antonioastorino/Arduino-Micro-Keyboard/kicad/keyboard.kicad_pcb

## KiCad design kicad/keyboard.kicad_pcb (2024-11-29)

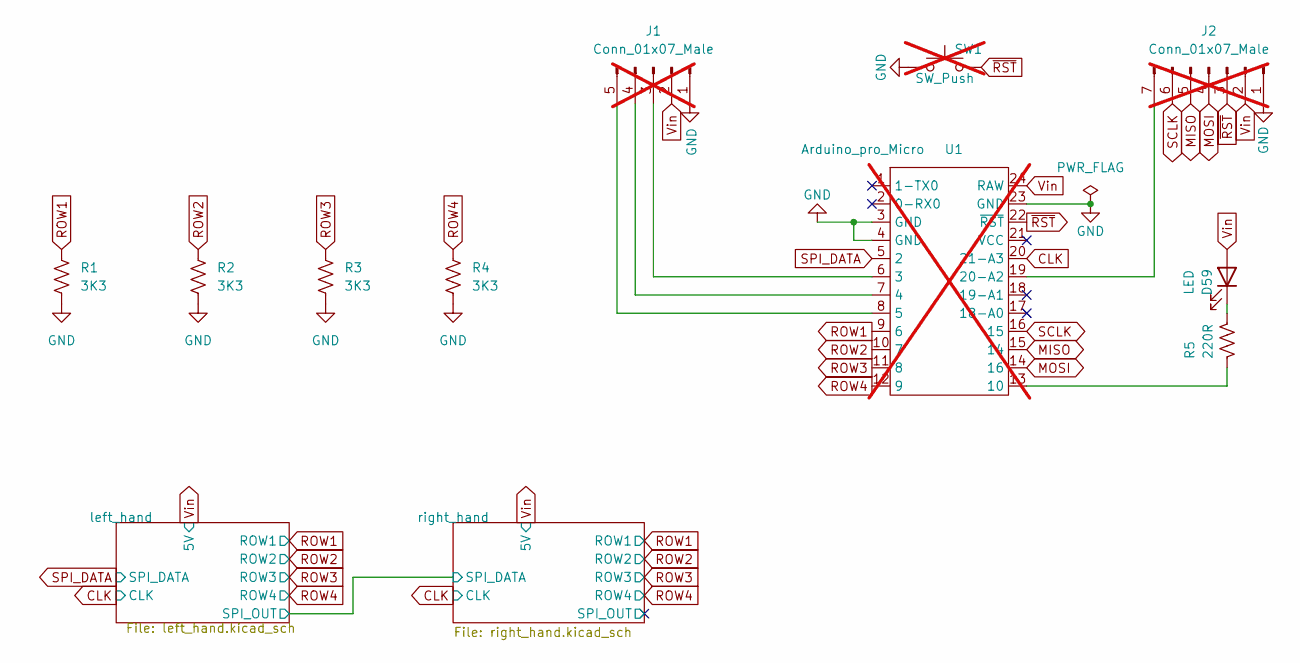
[picture p1: schematic keyboard.kicad_sch]

Parts:
D59: LED; LED_0805_2012Metric; LCSC C2296
J1: Conn_01x07_Male; PinHeader_1x05_P2.54mm_Vertical; not fitted
J2: Conn_01x07_Male; PinHeader_01x07; not fitted
R1, R2, R3, R4: 3K3; R_0603_1608Metric; LCSC C22978
R5: 220R; R_0603_1608Metric; LCSC C22962
SW1: SW_Push; DIP-2_P5.08mm; not fitted
U1: Arduino_pro_Micro; DIP-24_W15.24mm; not fitted

Connections:
CLK: U1.20 (21-A3); also elsewhere on the board
GND: J1.1, J2.1, R1.2, R2.2, R3.2, R4.2, SW1.1, U1.3 (GND), U1.4 (GND), U1.23 (GND); also elsewhere on the board
MISO: J2.5, U1.15 (14)
MOSI: J2.4, U1.14 (16)
unnamed: D59.1 (K), R5.2
unnamed: J1.3, U1.6 (3)
unnamed: J1.4, U1.7 (4)
unnamed: J1.5, U1.8 (5)
unnamed: J2.7, U1.19 (20-A2)
unnamed: R5.1, U1.13 (10)
ROW1: R1.1, U1.9 (6); also elsewhere on the board
ROW2: R2.1, U1.10 (7); also elsewhere on the board
ROW3: R3.1, U1.11 (8); also elsewhere on the board
ROW4: R4.1, U1.12 (9); also elsewhere on the board
SCLK: J2.6, U1.16 (15)
SPI_DATA: U1.5 (2); also elsewhere on the board
Vin: D59.2 (A), J1.2, J2.2, U1.24 (RAW); also elsewhere on the board
~RST: J2.3, SW1.2, U1.22 (~RST)

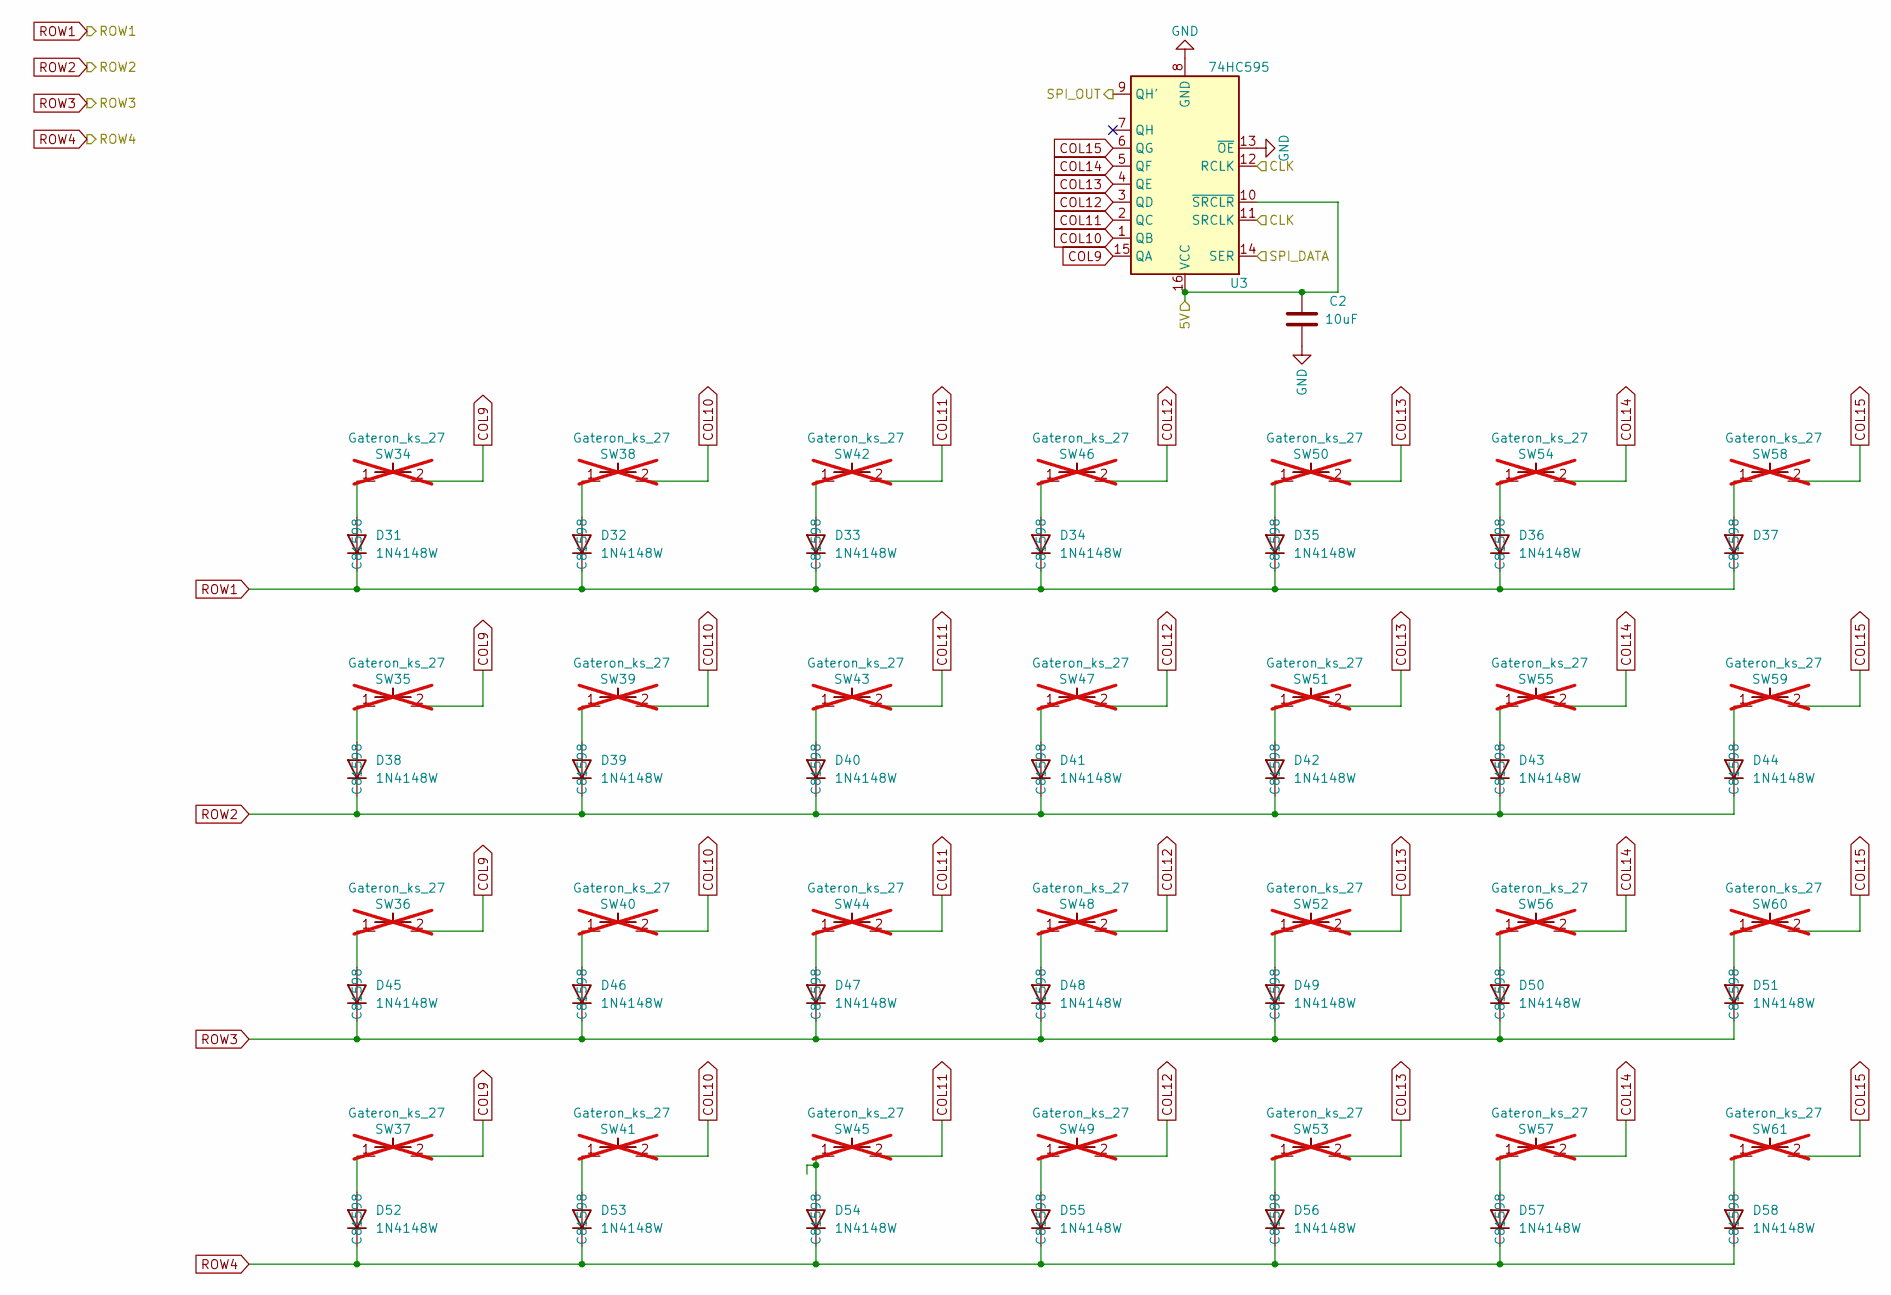
[picture p2: schematic right_hand.kicad_sch]

Parts:
C2: 10uF; C_0603_1608Metric; LCSC C19702
D31, D32, D33, D34, D35, D36, D37, D38, D39, D40, D41, D42, D43, D44, D45, D46, D47, D48, D49, D50, D51, D52, D53, D54, D55, D56, D57, D58: 1N4148W; D_SOD-123; LCSC C81598
SW34, SW35, SW36, SW37, SW38, SW39, SW40, SW41, SW42, SW43, SW44, SW45, SW46, SW47, SW48, SW49, SW50, SW51, SW52, SW53, SW54, SW55, SW56, SW57, SW58, SW59, SW60, SW61: Gateron_ks_27; not fitted
U3: 74HC595; SO-16_3.9x9.9mm_P1.27mm; LCSC C5947

Connections:
/left_hand/SPI_OUT: U3.14 (SER); also elsewhere on the board
/right_hand/SPI_OUT: U3.9 (QH')
CLK: U3.11 (SRCLK), U3.12 (RCLK); also elsewhere on the board
COL9: SW34.2, SW35.2, SW36.2, SW37.2, U3.15 (QA)
COL10: SW38.2, SW39.2, SW40.2, SW41.2, U3.1 (QB)
COL11: SW42.2, SW43.2, SW44.2, SW45.2, U3.2 (QC)
COL12: SW46.2, SW47.2, SW48.2, SW49.2, U3.3 (QD)
COL13: SW50.2, SW51.2, SW52.2, SW53.2, U3.4 (QE)
COL14: SW54.2, SW55.2, SW56.2, SW57.2, U3.5 (QF)
COL15: SW58.2, SW59.2, SW60.2, SW61.2, U3.6 (QG)
GND: C2.2, U3.8 (GND), U3.13 (~OE); also elsewhere on the board
unnamed: D31.2 (A), SW34.1
unnamed: D32.2 (A), SW38.1
unnamed: D33.2 (A), SW42.1
unnamed: D34.2 (A), SW46.1
unnamed: D35.2 (A), SW50.1
unnamed: D36.2 (A), SW54.1
unnamed: D37.2 (A), SW58.1
unnamed: D38.2 (A), SW35.1
unnamed: D39.2 (A), SW39.1
unnamed: D40.2 (A), SW43.1
unnamed: D41.2 (A), SW47.1
unnamed: D42.2 (A), SW51.1
unnamed: D43.2 (A), SW55.1
unnamed: D44.2 (A), SW59.1
unnamed: D45.2 (A), SW36.1
unnamed: D46.2 (A), SW40.1
unnamed: D47.2 (A), SW44.1
unnamed: D48.2 (A), SW48.1
unnamed: D49.2 (A), SW52.1
unnamed: D50.2 (A), SW56.1
unnamed: D51.2 (A), SW60.1
unnamed: D52.2 (A), SW37.1
unnamed: D53.2 (A), SW41.1
unnamed: D54.2 (A), SW45.1
unnamed: D55.2 (A), SW49.1
unnamed: D56.2 (A), SW53.1
unnamed: D57.2 (A), SW57.1
unnamed: D58.2 (A), SW61.1
ROW1: D31.1 (K), D32.1 (K), D33.1 (K), D34.1 (K), D35.1 (K), D36.1 (K), D37.1 (K); also elsewhere on the board
ROW2: D38.1 (K), D39.1 (K), D40.1 (K), D41.1 (K), D42.1 (K), D43.1 (K), D44.1 (K); also elsewhere on the board
ROW3: D45.1 (K), D46.1 (K), D47.1 (K), D48.1 (K), D49.1 (K), D50.1 (K), D51.1 (K); also elsewhere on the board
ROW4: D52.1 (K), D53.1 (K), D54.1 (K), D55.1 (K), D56.1 (K), D57.1 (K), D58.1 (K); also elsewhere on the board
Vin: C2.1, U3.10 (~SRCLR), U3.16 (VCC); also elsewhere on the board

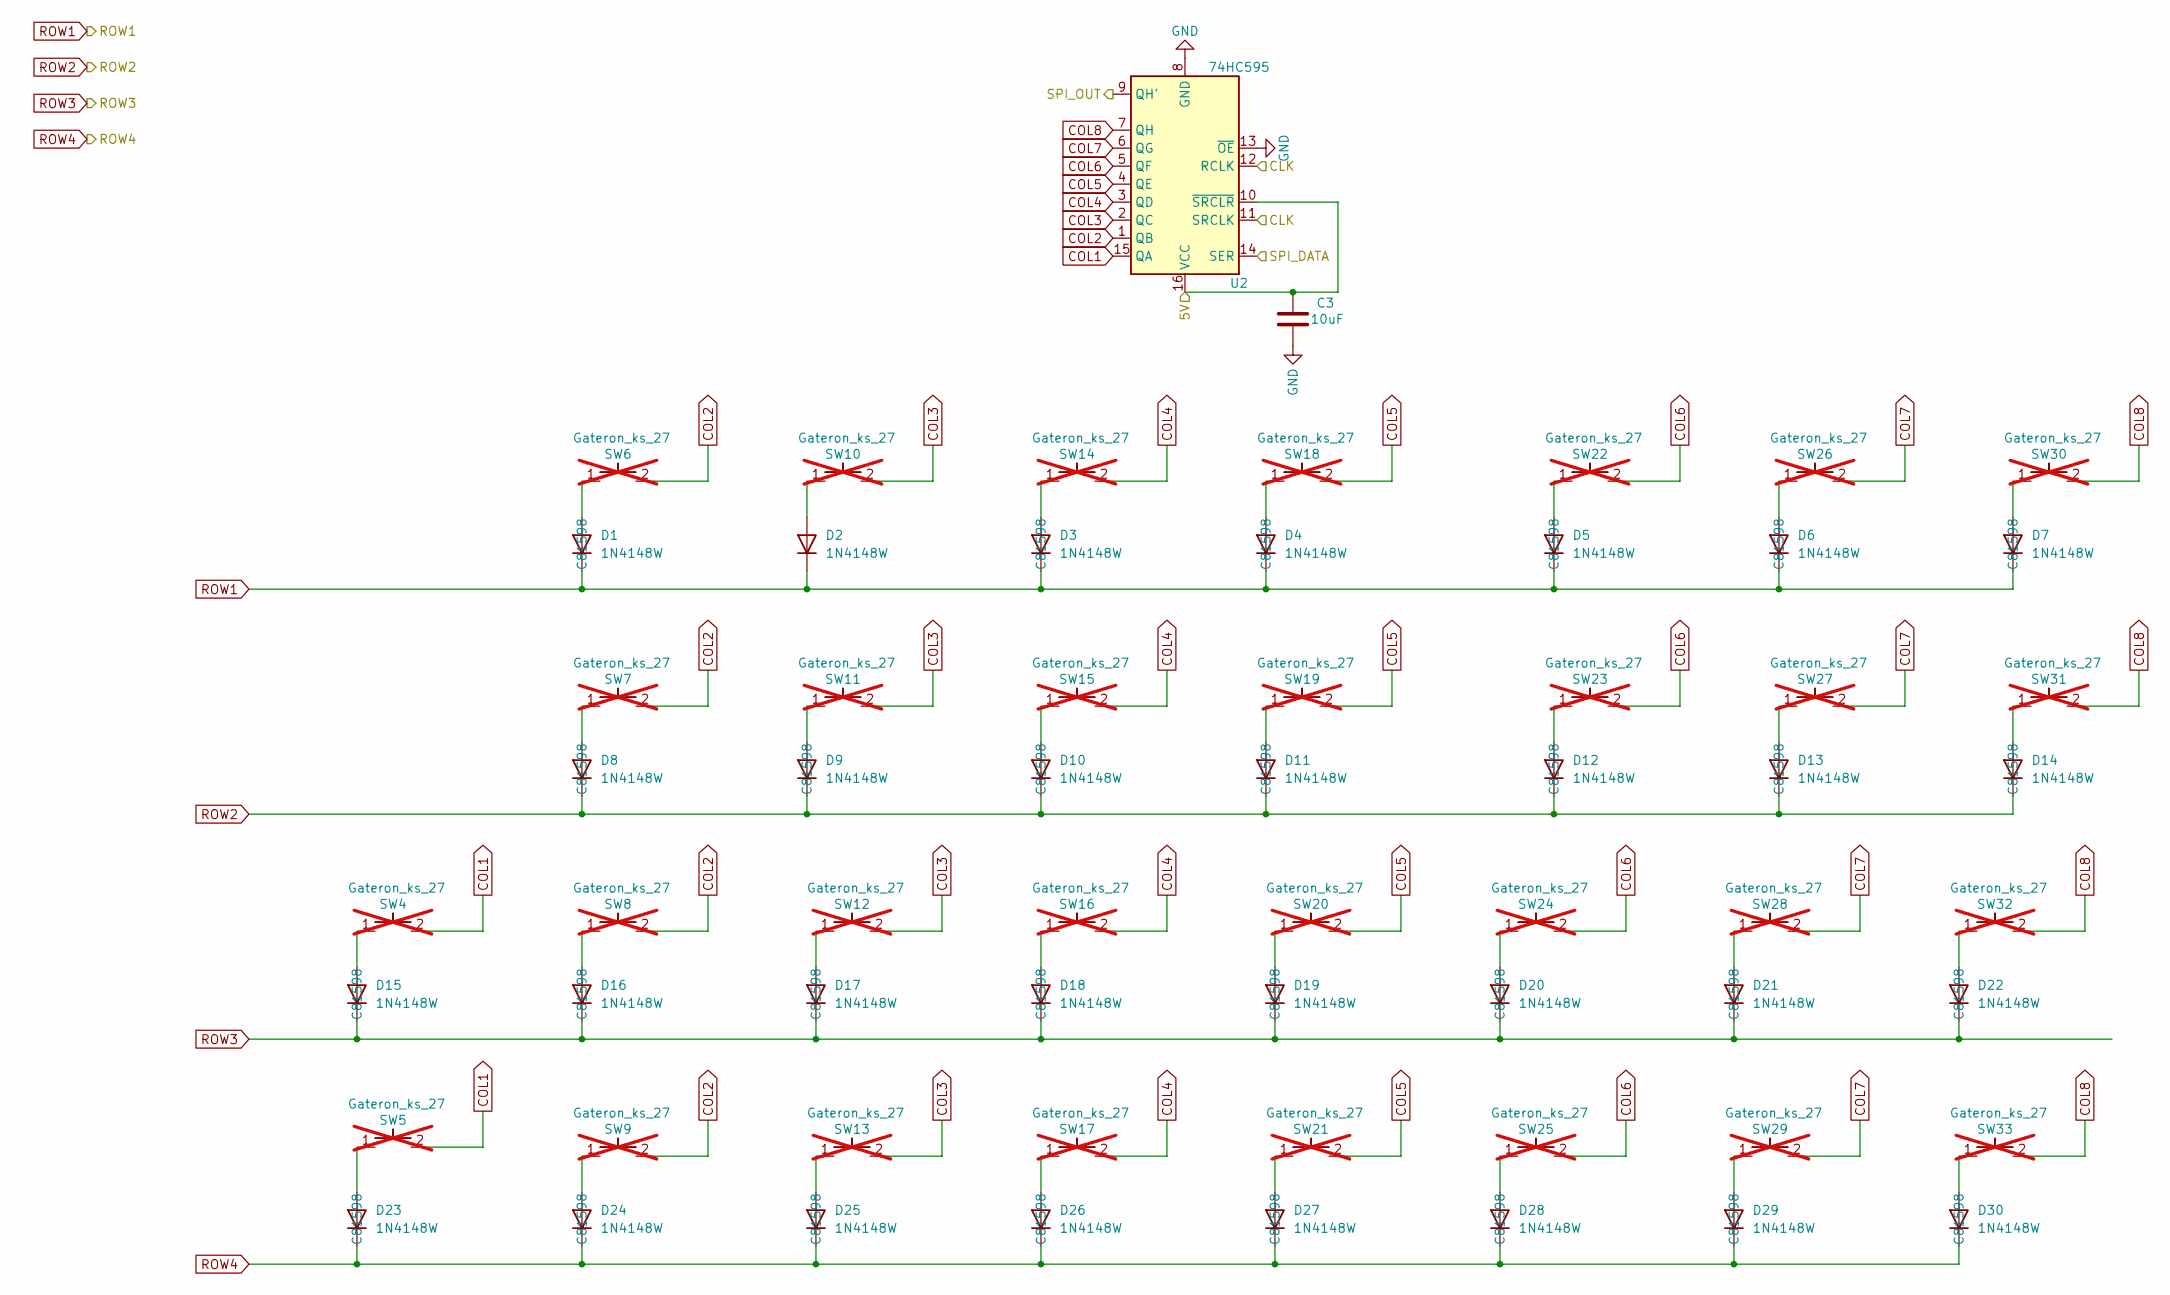
[picture p3: schematic left_hand.kicad_sch]

Parts:
C3: 10uF; C_0603_1608Metric; LCSC C19702
D1, D2, D3, D4, D5, D6, D7, D8, D9, D10, D11, D12, D13, D14, D15, D16, D17, D18, D19, D20, D21, D22, D23, D24, D25, D26, D27, D28, D29, D30: 1N4148W; D_SOD-123; LCSC C81598
SW4, SW5, SW6, SW7, SW8, SW9, SW10, SW11, SW12, SW13, SW14, SW15, SW16, SW17, SW18, SW19, SW20, SW21, SW22, SW23, SW24, SW25, SW26, SW27, SW28, SW29, SW30, SW31, SW32, SW33: Gateron_ks_27; not fitted
U2: 74HC595; SO-16_3.9x9.9mm_P1.27mm; LCSC C5947

Connections:
/left_hand/SPI_OUT: U2.9 (QH'); also elsewhere on the board
CLK: U2.11 (SRCLK), U2.12 (RCLK); also elsewhere on the board
COL1: SW4.2, SW5.2, U2.15 (QA)
COL2: SW6.2, SW7.2, SW8.2, SW9.2, U2.1 (QB)
COL3: SW10.2, SW11.2, SW12.2, SW13.2, U2.2 (QC)
COL4: SW14.2, SW15.2, SW16.2, SW17.2, U2.3 (QD)
COL5: SW18.2, SW19.2, SW20.2, SW21.2, U2.4 (QE)
COL6: SW22.2, SW23.2, SW24.2, SW25.2, U2.5 (QF)
COL7: SW26.2, SW27.2, SW28.2, SW29.2, U2.6 (QG)
COL8: SW30.2, SW31.2, SW32.2, SW33.2, U2.7 (QH)
GND: C3.2, U2.8 (GND), U2.13 (~OE); also elsewhere on the board
unnamed: D1.2 (A), SW6.1
unnamed: D2.2 (A), SW10.1
unnamed: D3.2 (A), SW14.1
unnamed: D4.2 (A), SW18.1
unnamed: D5.2 (A), SW22.1
unnamed: D6.2 (A), SW26.1
unnamed: D7.2 (A), SW30.1
unnamed: D8.2 (A), SW7.1
unnamed: D9.2 (A), SW11.1
unnamed: D10.2 (A), SW15.1
unnamed: D11.2 (A), SW19.1
unnamed: D12.2 (A), SW23.1
unnamed: D13.2 (A), SW27.1
unnamed: D14.2 (A), SW31.1
unnamed: D15.2 (A), SW4.1
unnamed: D16.2 (A), SW8.1
unnamed: D17.2 (A), SW12.1
unnamed: D18.2 (A), SW16.1
unnamed: D19.2 (A), SW20.1
unnamed: D20.2 (A), SW24.1
unnamed: D21.2 (A), SW28.1
unnamed: D22.2 (A), SW32.1
unnamed: D23.2 (A), SW5.1
unnamed: D24.2 (A), SW9.1
unnamed: D25.2 (A), SW13.1
unnamed: D26.2 (A), SW17.1
unnamed: D27.2 (A), SW21.1
unnamed: D28.2 (A), SW25.1
unnamed: D29.2 (A), SW29.1
unnamed: D30.2 (A), SW33.1
ROW1: D1.1 (K), D2.1 (K), D3.1 (K), D4.1 (K), D5.1 (K), D6.1 (K), D7.1 (K); also elsewhere on the board
ROW2: D8.1 (K), D9.1 (K), D10.1 (K), D11.1 (K), D12.1 (K), D13.1 (K), D14.1 (K); also elsewhere on the board
ROW3: D15.1 (K), D16.1 (K), D17.1 (K), D18.1 (K), D19.1 (K), D20.1 (K), D21.1 (K), D22.1 (K); also elsewhere on the board
ROW4: D23.1 (K), D24.1 (K), D25.1 (K), D26.1 (K), D27.1 (K), D28.1 (K), D29.1 (K), D30.1 (K); also elsewhere on the board
SPI_DATA: U2.14 (SER); also elsewhere on the board
Vin: C3.1, U2.10 (~SRCLR), U2.16 (VCC); also elsewhere on the board

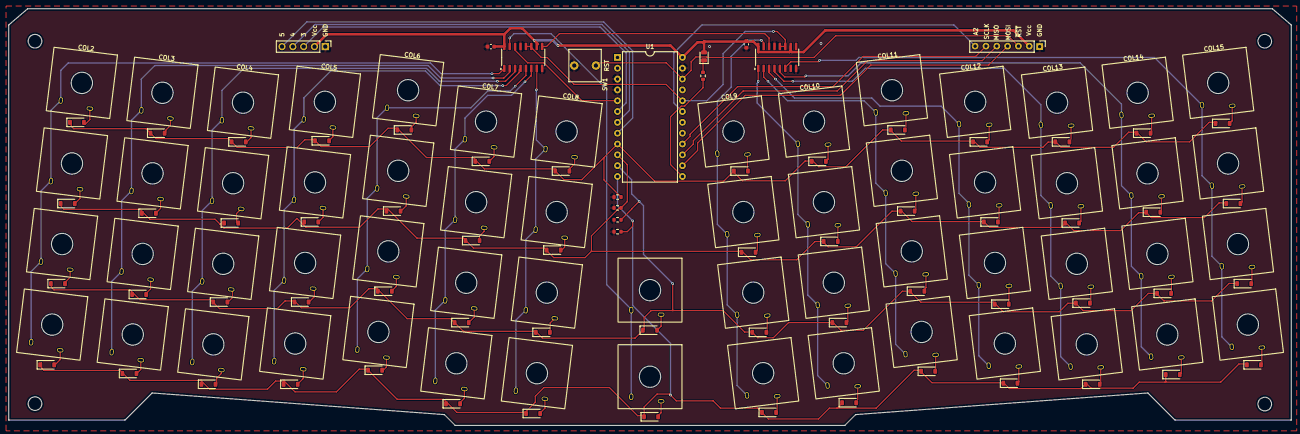
[picture p4: board keyboard.kicad_pcb from above]

Board: 2 copper layers, 301.0 x 97.8 mm, 130 parts (0 on the bottom side), 92 nets.
