antonioastorino/Arduino-Micro-Keyboard/keyboard/keyboard.ino

#include "my-keyboard.h"
#define LED 17
#define CLK 21
#define S_DATA 2
#define COLS 16
#define ROWS 4
#define MAX_SIMULTANELUS_KEYS (12)
// Numeric keypad
#define KEY_LAYER_NUM 255
#define KEY_LAYER_SYM 254
#define KEY_FN_01 0
#define KEY_FN_02 0
#define KEY_FN_03 0
#define KEY_FN_04 0
#define KEY_FN_05 KEY_VOLUMEDOWN
#define KEY_FN_06 KEY_VOLUMEUP
#define KEY_FN_07 KEY_F14
#define KEY_FN_08 KEY_F15
#define KEY_MOD_LCMD KEY_MOD_LMETA
#define KEY_MOD_RCMD KEY_MOD_RMETA
#define KEY_MOD_LOPTION KEY_MOD_LALT
#define KEY_MOD_ROPTION KEY_MOD_RALT
#define INDEX_KEY 0
#define INDEX_MOD 1

uint8_t layout_0[ROWS][COLS][2] = {
    {
        {KEY_FN_01, 0},
        {KEY_ESC, 0},
        {KEY_TAB, 0},
        {KEY_Q, 0},
        {KEY_W, 0},
        {KEY_E, 0},
        {KEY_R, 0},
        {KEY_T, 0},
        {KEY_Y, 0},
        {KEY_U, 0},
        {KEY_I, 0},
        {KEY_O, 0},
        {KEY_P, 0},
        {KEY_LEFTBRACE, 0},
        {KEY_RIGHTBRACE, 0},
        {KEY_FN_05, 0},
    },
    {
        {KEY_FN_02, 0},
        {KEY_CAPSLOCK, 0},
        {KEY_GRAVE, 0},
        {KEY_A, 0},
        {KEY_S, 0},
        {KEY_D, 0},
        {KEY_F, 0},
        {KEY_G, 0},
        {KEY_H, 0},
        {KEY_J, 0},
        {KEY_K, 0},
        {KEY_L, 0},
        {KEY_SEMICOLON, 0},
        {KEY_APOSTROPHE, 0},
        {KEY_ENTER, 0},
        {KEY_FN_06, 0},
    },
    {
        {0, 0},
        {0, 0},
        {0, KEY_MOD_LSHIFT},
        {KEY_Z, 0},
        {KEY_X, 0},
        {KEY_C, 0},
        {KEY_V, 0},
        {KEY_B, 0},
        {KEY_N, 0},
        {KEY_M, 0},
        {KEY_COMMA, 0},
        {KEY_DOT, 0},
        {KEY_SLASH, 0},
        {0, KEY_MOD_RSHIFT},
        {0, 0},
        {KEY_FN_07, 0},
    },
    {
        {0, 0},
        {0, 0},
        {0, KEY_MOD_LCTRL},
        {0, KEY_MOD_LOPTION},
        {0, KEY_MOD_LCMD},
        {0, KEY_LAYER_SYM},
        {0, KEY_LAYER_NUM},
        {KEY_BACKSPACE, 0},
        {KEY_SPACE, 0},
        {KEY_BACKSLASH, 0},
        {0, 0},
        {KEY_LEFT, 0},
        {KEY_DOWN, 0},
        {KEY_UP, 0},
        {KEY_RIGHT, 0},
        {KEY_FN_08, 0},
    },
};

uint8_t layout_1[ROWS][COLS][2] = {
    {
        {0, 0},
        {KEY_ESC, 0},
        {0, 0},
        {0, 0},
        {0, 0},
        {0, 0},
        {0, 0},
        {0, 0},
        {0, 0},
        {KEY_KP7, 0},
        {KEY_KP8, 0},
        {KEY_KP9, 0},
        {KEY_KPEQUAL, 0},
        {0, 0},
        {0, 0},
        {0, 0},
    },
    {
        {0, 0},
        {0, 0},
        {0, 0},
        {0, 0},
        {0, 0},
        {0, 0},
        {0, 0},
        {0, 0},
        {0, 0},
        {KEY_KP4, 0},
        {KEY_KP5, 0},
        {KEY_KP6, 0},
        {KEY_KPPLUS, 0},
        {0, 0},
        {KEY_KPENTER, 0},
        {0, 0},
    },
    {
        {0, 0},
        {0, 0},
        {0, 0},
        {0, 0},
        {0, 0},
        {0, 0},
        {0, 0},
        {0, 0},
        {0, 0},
        {KEY_KP1, 0},
        {KEY_KP2, 0},
        {KEY_KP3, 0},
        {KEY_KPMINUS, 0},
        {0, 0},
        {0, 0},
        {0, 0},
    },
    {
        {0, 0},
        {0, 0},
        {0, KEY_MOD_LCTRL},
        {0, KEY_MOD_LOPTION},
        {0, KEY_MOD_LCMD},
        {0, 0},
        {0, KEY_LAYER_NUM},
        {KEY_BACKSPACE, 0},
        {KEY_SPACE, 0},
        {KEY_KP0, 0},
        {KEY_KPSLASH, 0},
        {KEY_KPDOT, 0},
        {KEY_KPASTERISK, 0},
        {0, 0},
        {0, 0},
        {0, 0},
    },
};

uint8_t layout_2[ROWS][COLS][2] = {
    {
        {0, 0},
        {0, 0},
        {0, 0},
        {KEY_1, KEY_MOD_LSHIFT},
        {KEY_2, KEY_MOD_LSHIFT},
        {KEY_3, KEY_MOD_LSHIFT},
        {KEY_4, KEY_MOD_LSHIFT},
        {KEY_5, KEY_MOD_LSHIFT},
        {KEY_6, KEY_MOD_LSHIFT},
        {KEY_7, KEY_MOD_LSHIFT},
        {KEY_8, KEY_MOD_LSHIFT},
        {KEY_9, KEY_MOD_LSHIFT},
        {KEY_0, KEY_MOD_LSHIFT},
        {KEY_MINUS, KEY_MOD_LSHIFT},
        {0, 0},
        {0, 0},
    },
    {
        {0, 0},
        {0, 0},
        {0, 0},
        {0, 0},
        {0, 0},
        {0, 0},
        {0, 0},
        {KEY_EQUAL, KEY_MOD_LCMD},
        {KEY_LEFT, 0},
        {KEY_DOWN, 0},
        {KEY_UP, 0},
        {KEY_RIGHT, 0},
        {0, 0},
        {0, KEY_MOD_RSHIFT},
        {0, 0},
        {0, 0},
    },
    {
        {0, 0},
        {0, 0},
        {0, KEY_MOD_LSHIFT},
        {0, 0},
        {0, 0},
        {0, 0},
        {0, 0},
        {KEY_MINUS, KEY_MOD_LCMD},
        {0, 0},
        {0, 0},
        {0, 0},
        {0, 0},
        {0, 0},
        {0, KEY_MOD_RSHIFT},
        {0, 0},
        {0, 0},
    },
    {
        {0, 0},
        {0, 0},
        {0, KEY_MOD_LCTRL},
        {0, KEY_MOD_LOPTION},
        {0, KEY_MOD_LCMD},
        {0, KEY_LAYER_SYM},
        {0, 0},
        {0, 0},
        {0, 0},
        {KEY_DELETE, 0},
        {0, 0},
        {0, 0},
        {0, 0},
        {0, 0},
        {0, 0},
        {0, 0},
    },
};

const uint8_t row_to_pin[ROWS] = {6, 7, 8, 9};
char monitor_str[64]           = {0};
uint8_t (*current_layout)[ROWS][COLS][2];
bool shouldSendPage = false;

typedef struct _keyPressed
{
    uint8_t row;
    uint8_t col;
} keyPressed;

bool key_num_pressed = false;
bool key_sym_pressed = false;

void flush_registers()
{
    digitalWrite(S_DATA, LOW);
    for (uint8_t b = 0; b < 15; b++)
    {
        digitalWrite(CLK, HIGH);
        digitalWrite(CLK, LOW);
    }
    // Assert the last bit - this will be the first loaded in the shift register
    digitalWrite(S_DATA, HIGH);
    digitalWrite(CLK, HIGH);
    digitalWrite(CLK, LOW);
}

void setup()
{
    current_layout = &layout_0;
#ifdef DEBUG
    Serial.begin(115200);
    delay(2000);
#endif
    for (int i = 0; i < ROWS; i++)
    {
        pinMode(row_to_pin[i], INPUT);
        digitalWrite(row_to_pin[i],
                     LOW); // should disable internal pull-up resistors
    }
    pinMode(LED, OUTPUT);
    pinMode(CLK, OUTPUT);
    pinMode(S_DATA, OUTPUT);
    Keyboard.begin();
}

void loop()
{
    uint8_t button   = 0;
    uint8_t modifier = 0;
    keyPressed key_pressed[MAX_SIMULTANELUS_KEYS];
    uint8_t key_pressed_counter = 0;
    bool new_key_num_pressed    = false;
    bool new_key_sym_pressed    = false;
    delay(10);

    Keyboard.releaseAll();
    digitalWrite(S_DATA, LOW);
    for (int col = 0; col < COLS; col++)
    {
        if (col == COLS - 1)
        {
            digitalWrite(S_DATA, HIGH);
        }
        digitalWrite(CLK, HIGH);
        digitalWrite(CLK, LOW);
        for (int row = 0; row < ROWS && key_pressed_counter < MAX_SIMULTANELUS_KEYS; row++)
        {
            button   = (*current_layout)[row][col][INDEX_KEY];
            modifier = (*current_layout)[row][col][INDEX_MOD];
            if (digitalRead(row_to_pin[row]))
            {
                if (modifier == KEY_LAYER_NUM)
                {
                    new_key_num_pressed = true;
                    new_key_sym_pressed = false;
                    continue;
                }
                else if (modifier == KEY_LAYER_SYM)
                {
                    new_key_num_pressed = false;
                    new_key_sym_pressed = true;
                    continue;
                }
                key_pressed[key_pressed_counter].col = col;
                key_pressed[key_pressed_counter].row = row;
                key_pressed_counter++;
            }
        }
    }
    // Change layout and do not send this button
    if (new_key_num_pressed)
    {
        current_layout = &layout_1;
        digitalWrite(LED, LOW);
    }
    else if (new_key_sym_pressed)
    {
        current_layout = &layout_2;
        digitalWrite(LED, LOW);
    }
    else
    {
        digitalWrite(LED, HIGH);
        current_layout = &layout_0;
    }
    if (key_num_pressed != new_key_num_pressed)
    {
        flush_registers();
        Keyboard.releaseAll();
    }
    if (key_sym_pressed != new_key_sym_pressed)
    {
        flush_registers();
        Keyboard.releaseAll();
    }

    // Update keyboard state
    uint8_t button_pressed_count = 0;
    for (uint8_t p = 0; p < key_pressed_counter; p++)
    {
        uint8_t row      = key_pressed[p].row;
        uint8_t col      = key_pressed[p].col;
        uint8_t button   = (*current_layout)[row][col][INDEX_KEY];
        uint8_t modifier = (*current_layout)[row][col][INDEX_MOD];
        if (button && button_pressed_count < 6)
        {
            shouldSendPage = true;
            Keyboard.pressRaw(button, button_pressed_count);
            button_pressed_count++;
        }
        if (modifier)
        {
            shouldSendPage = true;
            Keyboard.setModifiers(modifier);
        }

#ifdef DEBUG
        sprintf(monitor_str, "Row: %d, Col: %d, B%d\n", row, col, button);
        Serial.println(monitor_str);
#endif
    }
#ifndef DEBUG
    if (shouldSendPage)
    {
        Keyboard.sendReport();
        shouldSendPage = false;
    }
#endif
    key_num_pressed = new_key_num_pressed;
    key_sym_pressed = new_key_sym_pressed;
}
