antonioastorino/Arduino-Micro-Keyboard/(commit log)

2024-07-29 TMP: remove unused stuff
    [keyboard.kicad_pcb, keyboard.kicad_sch, left_hand.kicad_sch, right_hand.kicad_sch]
2024-07-29 Last update
    [keyboard.kicad_sch, left_hand.kicad_sch, right_hand.kicad_sch, test.kicad_pcb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]
2024-07-29 Update switch diode
    [keyboard.kicad_pcb, keyboard.kicad_sch, left_hand.kicad_sch, right_hand.kicad_sch]
2024-11-17 Update PCB
    [keyboard.kicad_pcb, keyboard.kicad_sch, left_hand.kicad_sch, right_hand.kicad_sch]
2024-11-29 SIPO is SMT
    [keyboard.kicad_pcb, left_hand.kicad_sch, right_hand.kicad_sch, test.kicad_pcb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]
